Eccodyne/HOTAS-Throttle-Surottoru-/images/Base_Bottom.JPG

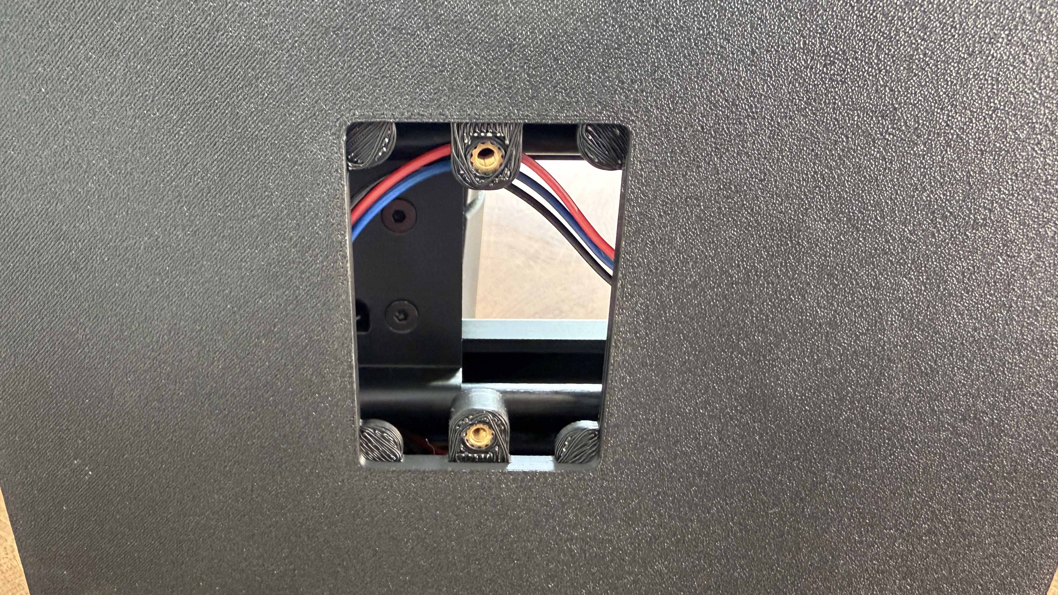
images/Base_Bottom.JPG
