Eccodyne/HOTAS-Throttle-Surottoru-/images/IMG_4241.JPG

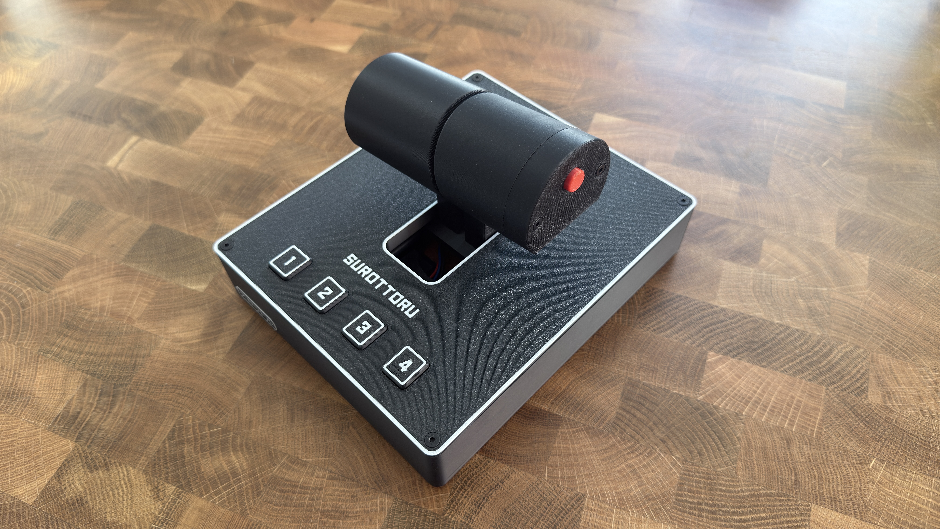
images/IMG_4241.JPG
