Eccodyne/HOTAS-Throttle-Surottoru-/images/Rod Holder.jpg

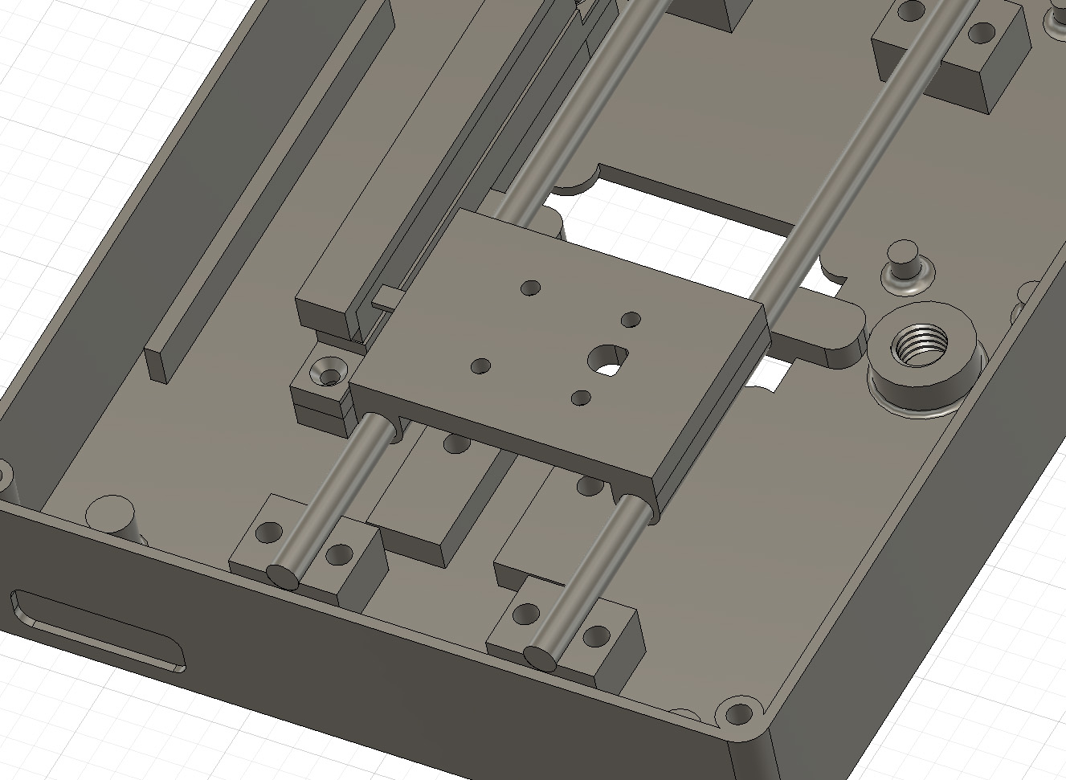
images/Rod Holder.jpg
