Eccodyne/HOTAS-Throttle-Surottoru-/images/Teaser_Vertical.jpg

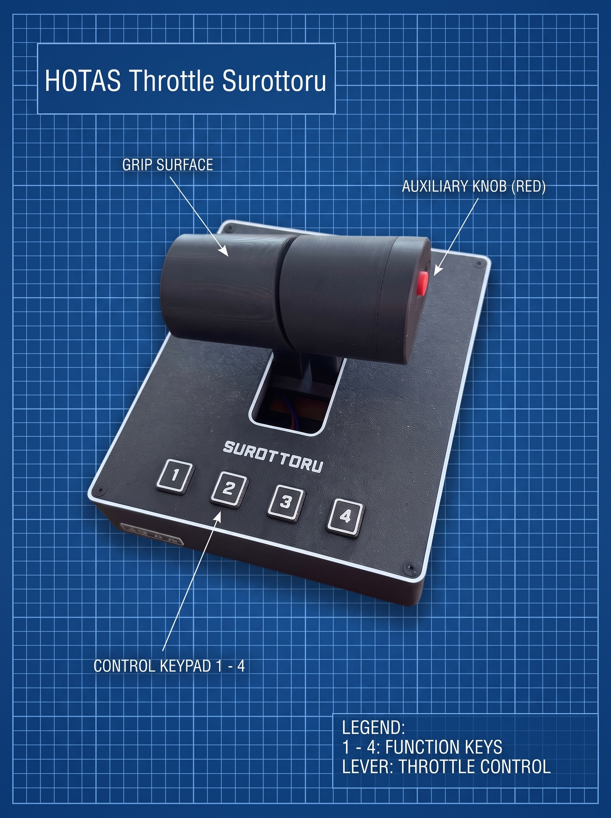
images/Teaser_Vertical.jpg
