Eccodyne/HOTAS-Throttle-Surottoru-/images/ESP_Wiring.JPG

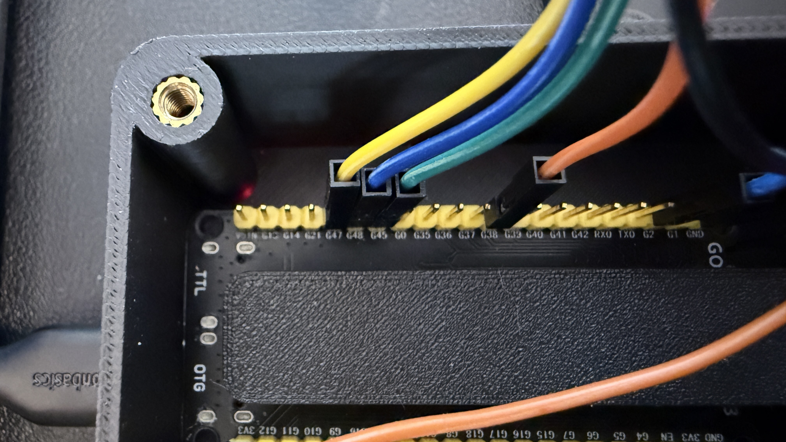
images/ESP_Wiring.JPG
