Eccodyne/HOTAS-Throttle-Surottoru-/images/Poti_Wiring.JPG

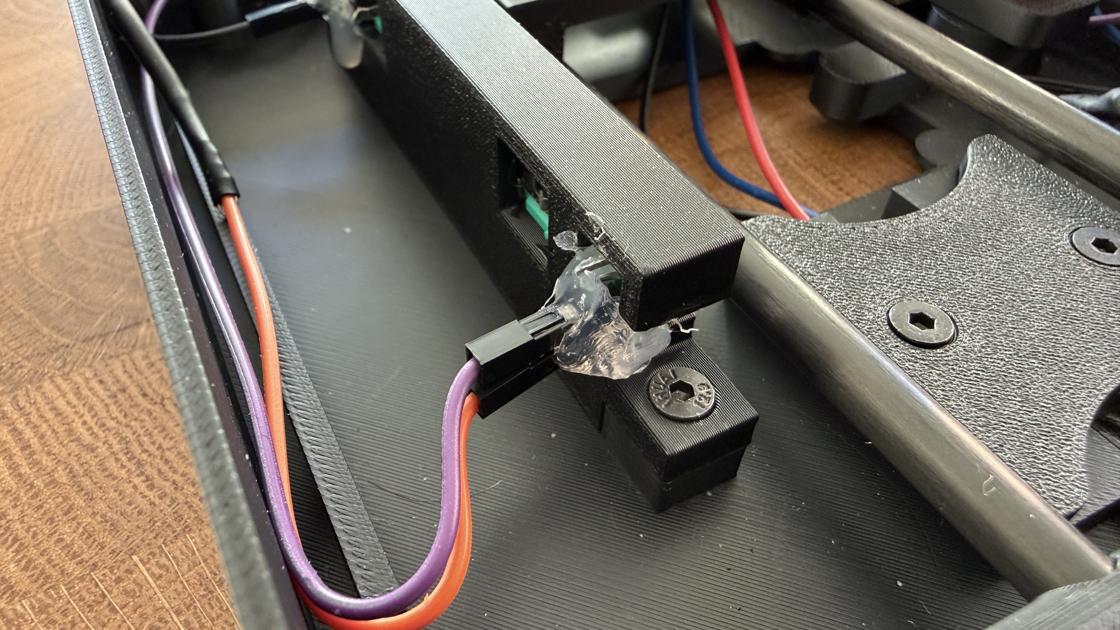
images/Poti_Wiring.JPG
