Eccodyne/HOTAS-Throttle-Surottoru-/HotasThrottleCode.ino

#include "USB.h"
#include "USBHIDGamepad.h"

// The object that simulates the joystick for Windows
USBHIDGamepad Gamepad;

// --- Pin configuration ---
const int potPin = 5;

/////////////////////////////////////////////////////////////////////////////////////////////////////
// APPLY YOUR INDIVIDUAL SETTINGS HERE!                                                              //
/////////////////////////////////////////////////////////////////////////////////////////////////////
const int buttonPins[] = {2, 38, 45, 47, 48};
const int numButtons = sizeof(buttonPins) / sizeof(buttonPins[0]);

int rawMinValue = 110;  
int rawMaxValue = 3900; 

/////////////////////////////////////////////////////////////////////////////////////////////////////

// --- Debounce storage ---
const unsigned long debounceDelay = 20; // ms
int lastButtonReading[16];
int lastButtonStates[16];
unsigned long lastDebounceTime[16];

// --- Throttle filter settings ---
const float smoothingAlpha = 0.20f;     
const int oversampleCount = 16;         
const unsigned long axisUpdateInterval = 5; 
const int axisHysteresis = 2;           

float smoothedValue = 0;
int lastSentAxisValue = -128;
unsigned long lastAxisUpdate = 0;

int readPotAveraged() {
  long sum = 0;
  for (int i = 0; i < oversampleCount; i++) {
    sum += analogRead(potPin);
  }
  return sum / oversampleCount;
}

void setup() {
  Serial.begin(115200); 

  // Consistent ADC configuration
  analogReadResolution(12);
  analogSetAttenuation(ADC_11db);

  // Initialize buttons (Mixed wiring)
  for (int i = 0; i < numButtons; i++) {
    if (i == 0) {
      pinMode(buttonPins[i], INPUT_PULLDOWN); // Button 1 switches 3.3V through
    } else {
      pinMode(buttonPins[i], INPUT_PULLUP);   // All others switch GND through
    }
    
    // Adapt initial status values to the pull resistors
    lastButtonReading[i] = (i == 0) ? LOW : HIGH;
    lastButtonStates[i] = (i == 0) ? LOW : HIGH;
    lastDebounceTime[i] = 0;
  }

  smoothedValue = readPotAveraged();

  // --- USB recognition for Windows ---
  USB.productName("Surottoru");
  USB.manufacturerName("Custom HOTAS Throttle");

  Gamepad.begin();
  USB.begin();
}

void loop() {
  unsigned long now = millis();

  // 1. BUTTONS
  for (int i = 0; i < numButtons; i++) {
    int reading = digitalRead(buttonPins[i]);

    if (reading != lastButtonReading[i]) {
      lastDebounceTime[i] = now;
    }

    if ((now - lastDebounceTime[i]) > debounceDelay) {
      if (reading != lastButtonStates[i]) {
        lastButtonStates[i] = reading;
        
        // Check if the button is considered "pressed"
        bool isPressed = false;
        if (i == 0 && reading == LOW) {     // CHANGED: Now reacts to LOW
          isPressed = true; 
        } else if (i > 0 && reading == LOW) {
          isPressed = true; 
        }

        if (isPressed) {
          Gamepad.pressButton(i + 1); 
        } else {
          Gamepad.releaseButton(i + 1);
        }
      }
    }
    lastButtonReading[i] = reading;
  }

  // 2. THROTTLE
  if (now - lastAxisUpdate >= axisUpdateInterval) {
    lastAxisUpdate = now;

    int rawValue = readPotAveraged();

    // Smoothing
    smoothedValue = (smoothingAlpha * rawValue) + ((1.0f - smoothingAlpha) * smoothedValue);
    int currentValue = (int)(smoothedValue + 0.5f);

    // Create a small "deadzone" at the physical ends so that 100% and 0% are securely held
    currentValue = constrain(currentValue, rawMinValue + 10, rawMaxValue - 20);

    // Mapping to Windows values
    int axisValue = map(currentValue, rawMinValue + 10, rawMaxValue - 20, -127, 127);
    axisValue = constrain(axisValue, -127, 127);

    // Hysteresis check. Only send if the change is greater than or equal to 2
    if (abs(axisValue - lastSentAxisValue) >= axisHysteresis) {
      Gamepad.leftStick(0, axisValue);
      lastSentAxisValue = axisValue;
    }
  }
}
