Eccodyne/HOTAS-Throttle-Surottoru-/(commit log)

2026-09-27 Update README with image and project title
    Added image for HOTAS Throttle Surottoru and updated project title.
2026-09-27 Revise README for HOTAS Throttle Surottoru project
    Updated project description for clarity and personalization.
2026-09-27 Revise assembly instructions in README.md
    Updated instructions for inserting M3 threaded inserts and soldering jumper wires for tactile buttons. Added steps for attaching the potentiometer and securing it in the housing.
2026-09-27 Update assembly instructions in README
    Revised assembly instructions for 3D printed components and electronic connections, ensuring clarity and consistency in the process.
2026-09-27 Revise project instructions and component connections
    Updated instructions for connecting components and added resistor details.
2026-09-27 Revise HOTAS throttle instructions and add Arduino setup
    Updated instructions for building the HOTAS throttle and added steps for running Arduino code.
2026-09-27 Update README with assembly and Arduino setup instructions
    Added detailed instructions for attaching components and running Arduino code.
2026-09-27 Clarify instructions for button pin configuration
2026-09-27 Add combined wires images to README
    Added images for combined wires in the README.
2026-09-27 Add images for combined wires in README
2026-09-27 Update README with additional materials and instructions
    Added super glue and hot glue to the list of required materials. Updated instructions to include using super glue for attaching the logo and clarified the connection steps for the potentiometer.
2026-09-27 Add heat-shrink tubings to materials list
    Added heat-shrink tubings to the list of required materials.
2026-09-27 Add ESP32-S3 image and description to README
2026-09-27 Revise README to streamline project introduction
    Removed introductory details about the HOTAS Throttle Surottoru project.
2026-09-27 Add image for tactile button in README
2026-09-28 Enhance README with throttle movement details
    Added details about throttle movement and button configuration.
2026-09-28 Improve README throttle movement description
    Reworded throttle movement and button mapping description for clarity.
